oldrev/led-matrix/README.md

# 蓝牙 LED 矩阵控制器

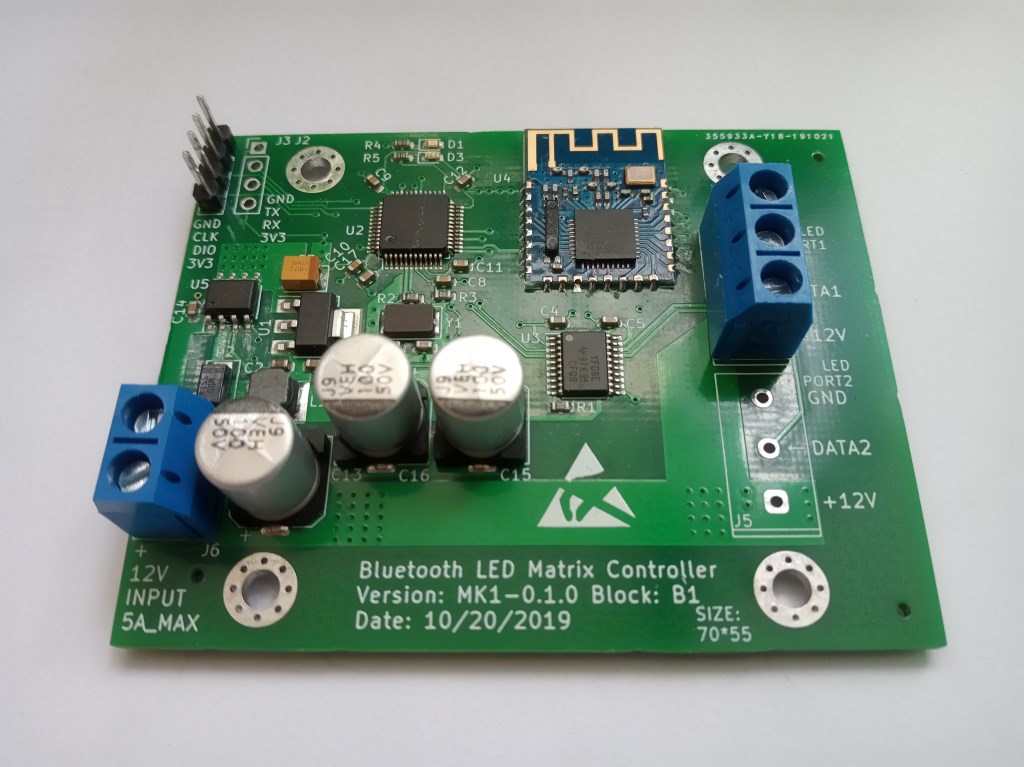
[picture p1: docs/images/board_photo.jpg]
PCB


详情文档推荐使用 mkdocs 构建并查看。

构建文档需要先安装 Python3 及相关依赖：

```bash
$pip install --user -r requirements.txt
```

安装完成以后，执行：

```bash
$mkdocs serve
```

然后用浏览器打开`http://localhost:8000`即可。
