oldrev/led-matrix/docs/index.md

PCB

# 关于此文档

**本项目文档使用 mkdocs 生成。**

For full documentation visit [mkdocs.org](https://mkdocs.org).

## 文档命令

* `mkdocs new [dir-name]` - Create a new project.
* `mkdocs serve` - Start the live-reloading docs server.
* `mkdocs build` - Build the documentation site.
* `mkdocs help` - Print this help message.

## 项目布局

    mkdocs.yml    # mkdocs 配置
    docs          # 文档目录
    firmware      # 单片机程序源代码
    demo          # 演示小程序源码
    circuit       # 电路设计文件（使用 KiCAD 5.1）
    casing        # 外壳建模文件（使用 FreeCAD）
    assets        # 参考文档等
