oldrev/led-matrix/docs/hw/casing.md

# 关于外壳

外壳使用公版防水室外接线盒。

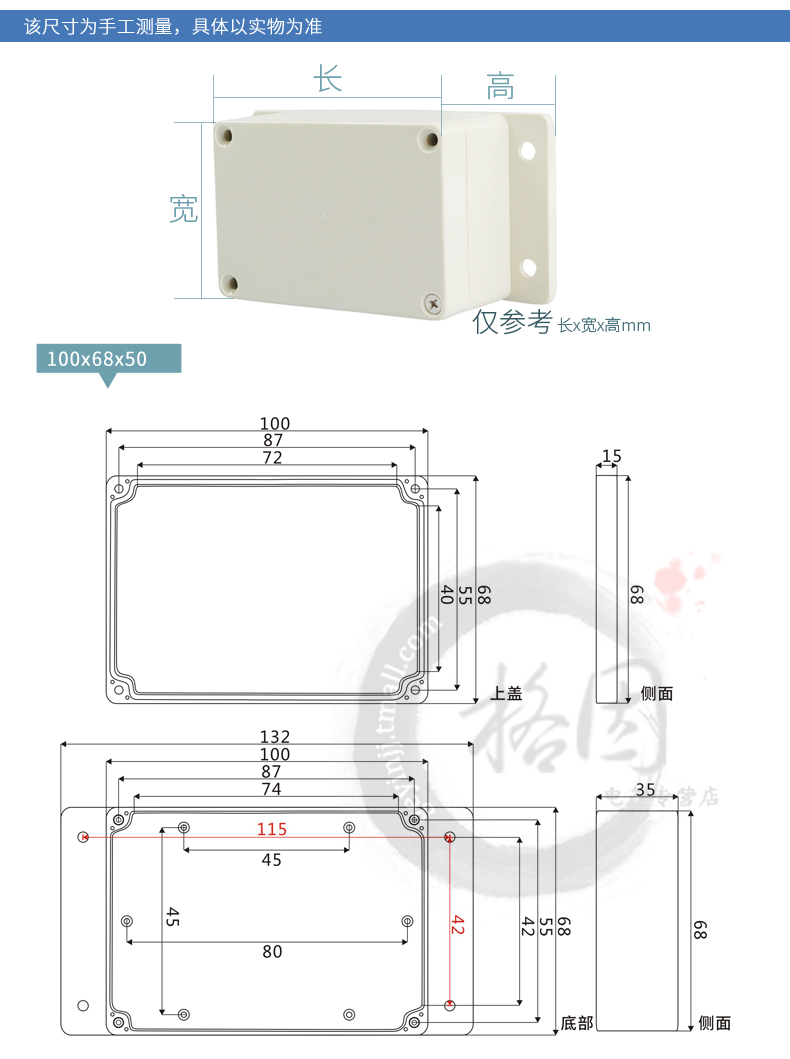
[picture p2: docs/hw/images/case_size.jpg]
PCB接口
