oldrev/led-matrix/casing/board.FCStd

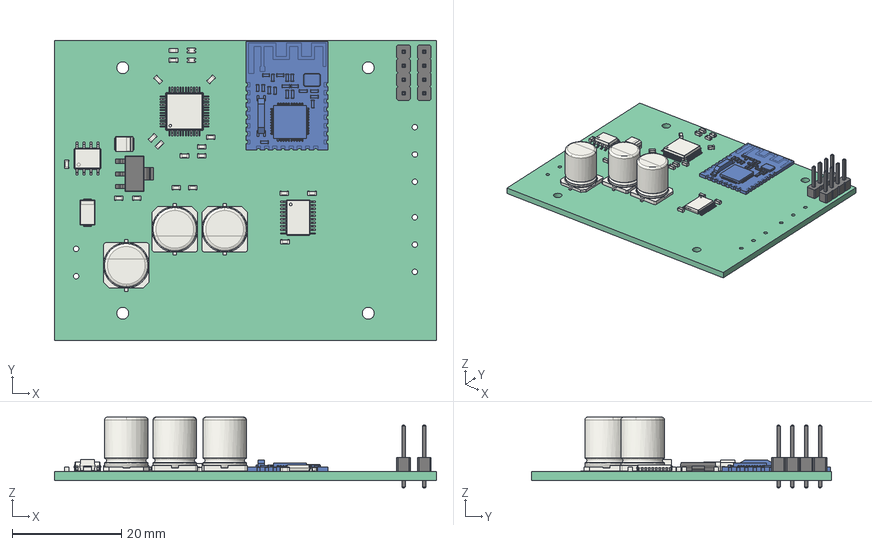
[picture p5: CAD file, 2019-11-02]
casing/board.FCStd
70.0 x 55.0 x 13.0 mm
Pcb
U3_TSSOP_20_44x65mm_P065mm_5DA9C0DB
U4_JDY-08_5DAB388E
C17_C_0603_1608Metric_5DAB3591
D3_D_0603_5DAB6C1B
C2_C_0603_1608Metric_5DAC7A63
J3_PinHeader_1x04_P254mm_Vertical_5DAB4AF9
J2_PinHeader_1x04_P254mm_Vertical_5DAB4AE1
C3_CP_EIA_3528_21_Kemet_B_5DAC7A95
C16_CP_Elec_8x10_5DAB24C7
C15_CP_Elec_8x10_5DAB249F
C13_CP_Elec_8x10_5DAB161F
D1_D_0603_5DAAA58A
U5_SOIC_8_39x49mm_P127mm_5DAA9B0B
D2_D_SMA_5DAA992D
C14_C_0603_1608Metric_5DAA9915
R5_C_0603_1608Metric_5DAA12DD
R4_C_0603_1608Metric_5DAA12CC
R3_C_0603_1608Metric_5DAA12BB
R2_C_0603_1608Metric_5DAA12AA
R1_C_0603_1608Metric_5DAA1299
C12_C_0603_1608Metric_5DAA1288
C11_C_0603_1608Metric_5DAA1277
C10_C_0603_1608Metric_5DAA1266
C9_C_0603_1608Metric_5DAA1255
C8_C_0603_1608Metric_5DAA1244
C7_C_0603_1608Metric_5DAA1233
C6_C_0603_1608Metric_5DAA1222
C5_C_0603_1608Metric_5DAA1211
C4_C_0603_1608Metric_5DAA1200
C1_C_0603_1608Metric_5DAC7AC9
U2_LQFP_48_7x7mm_P05mm_5DA9C0B7
U1_SOT_223_5DAC7AFE
