oldrev/led-matrix/circuit/3D-Package/JDY-08.stp

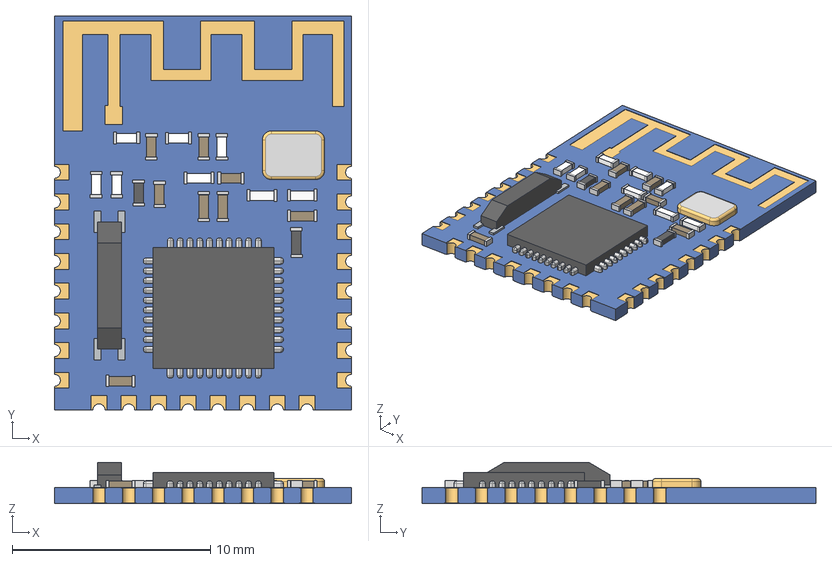
[picture p6: CAD file, 2019-11-02]
circuit/3D-Package/JDY-08.stp
15.0 x 19.9 x 2.08 mm
