oldrev/led-matrix/circuit/3D-Package/Crystal-5032-2P.stp

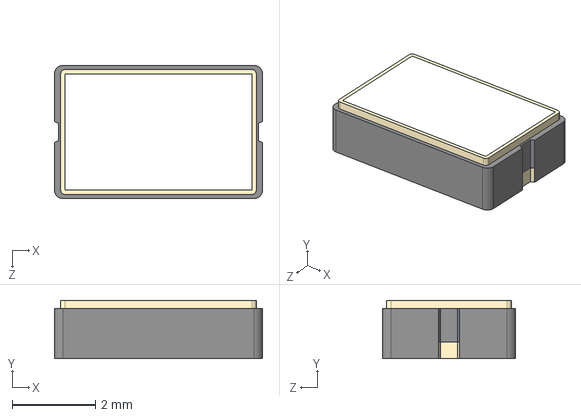
[picture p8: CAD file, 2019-11-02]
circuit/3D-Package/Crystal-5032-2P.stp
5.00 x 1.40 x 3.20 mm
