oldrev/led-matrix/circuit/LEDMatrix.kicad_pcb

## KiCad design circuit/LEDMatrix.kicad_pcb (2020-04-25)

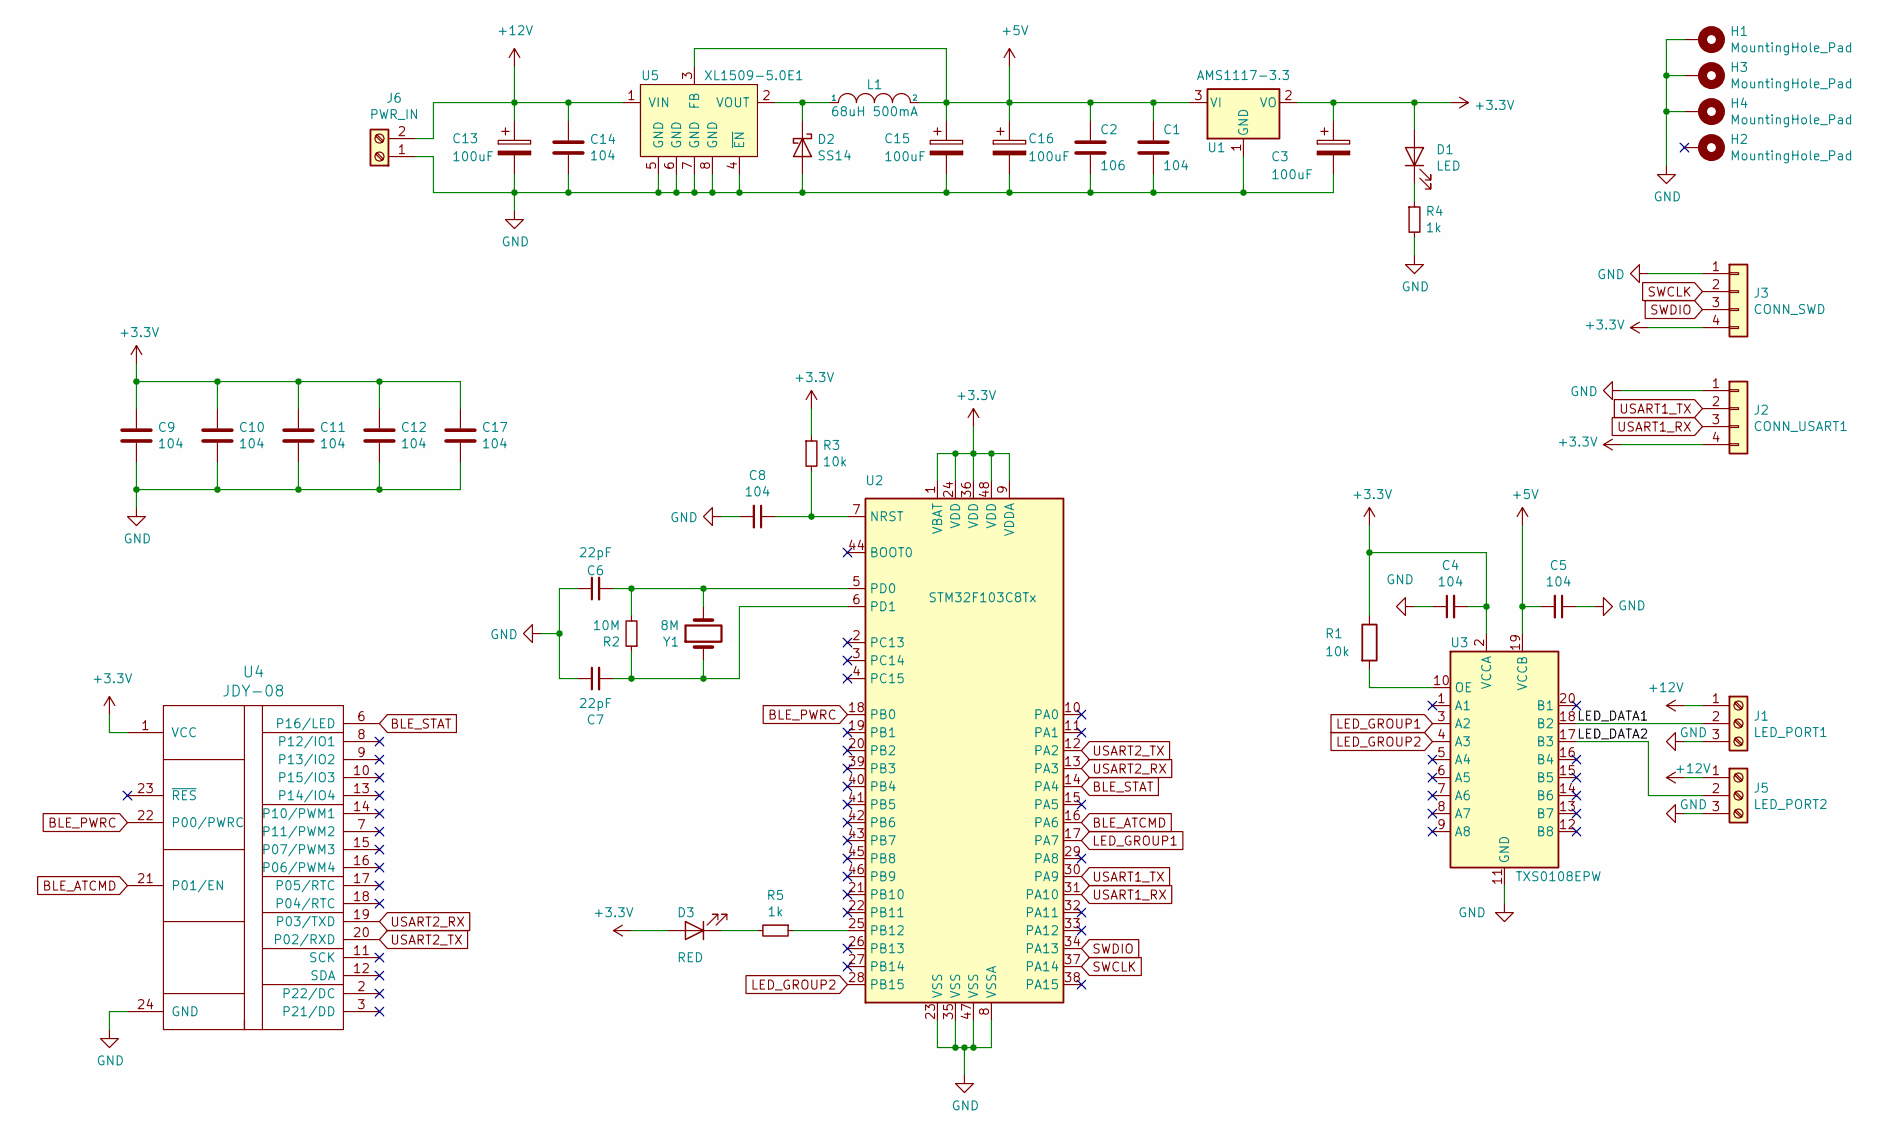
[picture p9: schematic LEDMatrix.sch, LED Matrix BLE Controller]

Parts:
C1, C4, C5, C8, C9, C10, C11, C12, C14, C17: 104; C_0603_1608Metric
C2: 106; C_0603_1608Metric; JLC_MODEL C19702
C3: 100uF; CP_EIA-3528-21_Kemet-B; JLC_MODEL TAJB107K006RNJ
C6, C7: 22pF; C_0603_1608Metric
C13, C15, C16: 100uF; CP_Elec_8x10; JLC_MODEL C134507
D1: LED; D_0603_1608Metric
D2: SS14; D_SMA
D3: RED; D_0603_1608Metric
H1, H2, H3, H4: MountingHole_Pad; MountingHole_3.2mm_M3_Pad_Via
J1: LED_PORT1; TerminalBlock_JL301-5.00-3P
J2: CONN_USART1; PinHeader_1x04_P2.54mm_Vertical
J3: CONN_SWD; PinHeader_1x04_P2.54mm_Vertical
J5: LED_PORT2; TerminalBlock_JL301-5.00-3P
J6: PWR_IN; TerminalBlock_JL301-5.00-2P
L1: 68uH 500mA; L_Taiyo-Yuden_NR-40xx_HandSoldering
R1, R3: 10k; C_0603_1608Metric
R2: 10M; C_0603_1608Metric
R4, R5: 1k; C_0603_1608Metric
U1: AMS1117-3.3; SOT-223-3_TabPin2; JLC_MODEL C6186
U2: STM32F103C8Tx; LQFP-48_7x7mm_P0.5mm
U3: TXS0108EPW; TSSOP-20_4.4x6.5mm_P0.65mm
U4: JDY-08; JDY-08_HandSoldering
U5: XL1509-5.0E1; SOIC-8_3.9x4.9mm_P1.27mm; JLC_MODEL C61063
Y1: 8M; Crystal_SMD_5032-2Pin_5.0x3.2mm; JLC_MODEL C115962

Connections:
+3V3: C3.1, C4.2, C9.1, C10.1, C11.1, C12.1, C17.1, D1.2 (A), D3.2 (A), J2.4, J3.4, R1.1, R3.1, U1.2 (VO), U2.1 (VBAT), U2.9 (VDDA), U2.24 (VDD), U2.36 (VDD), U2.48 (VDD), U3.2 (VCCA), U4.1 (VCC)
+5V: C1.1, C2.1, C5.2, C15.1, C16.1, L1.2, U1.3 (VI), U3.19 (VCCB), U5.3 (FB)
+12V: C13.1, C14.1, J1.1, J5.1, J6.2, U5.1 (VIN)
/LED_DATA1: J1.2, U3.18 (B2)
/LED_DATA2: J5.2, U3.17 (B3)
BLE_ATCMD: U2.16 (PA6), U4.21 (P01/EN)
BLE_PWRC: U2.18 (PB0), U4.22 (P00/PWRC)
BLE_STAT: U2.14 (PA4), U4.6 (P16/LED)
GND: C1.2, C2.2, C3.2, C4.1, C5.1, C6.1, C7.1, C8.2, C9.2, C10.2, C11.2, C12.2, C13.2, C14.2, C15.2, C16.2, C17.2, D2.2 (A), H1.1, H3.1, H4.1, J1.3, J2.1, J3.1, J5.3, J6.1, R4.2, U1.1 (GND), U2.8 (VSSA), U2.23 (VSS), U2.35 (VSS), U2.47 (VSS), U3.11 (GND), U4.24 (GND), U5.4 (~EN), U5.5 (GND), U5.6 (GND), U5.7 (GND), U5.8 (GND)
LED_GROUP1: U2.17 (PA7), U3.3 (A2)
LED_GROUP2: U2.28 (PB15), U3.4 (A3)
unnamed: C6.2, R2.2, U2.5 (PD0), Y1.2
unnamed: C7.2, R2.1, U2.6 (PD1), Y1.1
unnamed: C8.1, R3.2, U2.7 (NRST)
unnamed: D1.1 (K), R4.1
unnamed: D2.1 (K), L1.1, U5.2 (VOUT)
unnamed: D3.1 (K), R5.2
unnamed: R1.2, U3.10 (OE)
unnamed: R5.1, U2.25 (PB12)
SWCLK: J3.2, U2.37 (PA14)
SWDIO: J3.3, U2.34 (PA13)
USART1_RX: J2.3, U2.31 (PA10)
USART1_TX: J2.2, U2.30 (PA9)
USART2_RX: U2.13 (PA3), U4.19 (P03/TXD)
USART2_TX: U2.12 (PA2), U4.20 (P02/RXD)

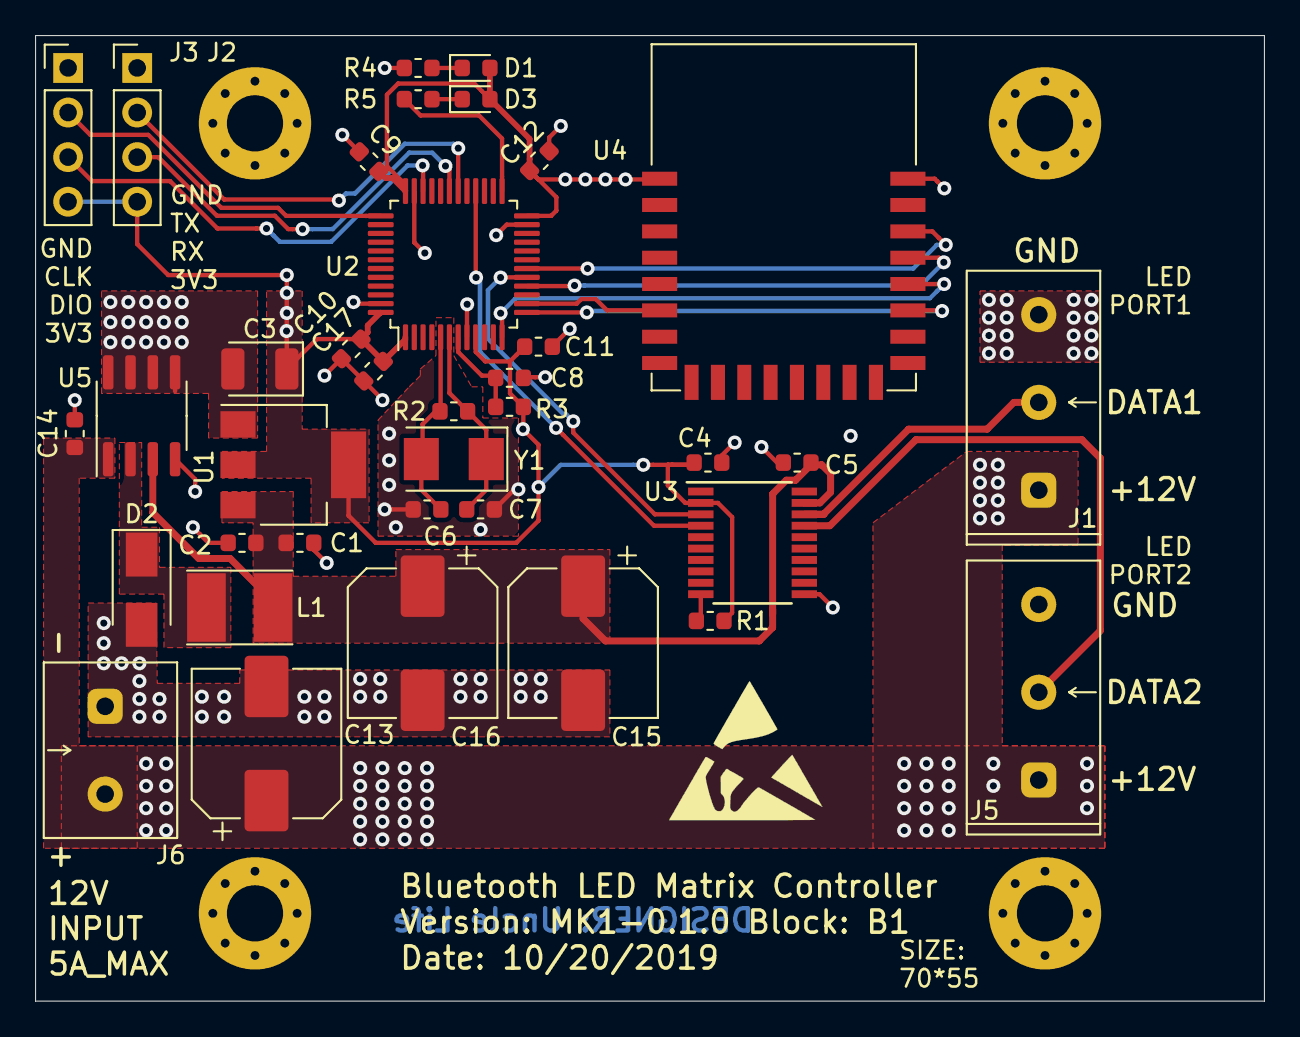
[picture p10: board LEDMatrix.kicad_pcb from above]

Board: 2 copper layers, 70.0 x 55.0 mm, 41 parts (0 on the bottom side), 25 nets.
