oldrev/led-matrix/firmware/Src/main.c

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

/* Includes ------------------------------------------------------------------*/
#include "main.h"
#include "cmsis_os.h"

/* USER CODE BEGIN Includes */
#include <string.h>
#include <stdlib.h>

#include "devices/devices.h"
#include "settings.h"
#include "comm.h"
/* USER CODE END Includes */

SPI_HandleTypeDef hspi1;
SPI_HandleTypeDef hspi2;
DMA_HandleTypeDef hdma_spi1_tx;
DMA_HandleTypeDef hdma_spi2_tx;

UART_HandleTypeDef huart1;
UART_HandleTypeDef huart2;
DMA_HandleTypeDef hdma_usart2_tx;
DMA_HandleTypeDef hdma_usart2_rx;

osThreadId defaultTaskHandle;
osThreadId displayTaskHandle;
osMessageQId g_cmdBusHandle;
/* USER CODE BEGIN PV */

Display g_display[1];

/* USER CODE END PV */

void SystemClock_Config(void);
static void MX_GPIO_Init(void);
static void MX_DMA_Init(void);
static void MX_SPI1_Init(void);
static void MX_SPI2_Init(void);
static void MX_USART1_UART_Init(void);
static void MX_USART2_UART_Init(void);
void TaskProc_Default(void const * argument);
void TaskProc_Display(void const * argument);

/* USER CODE BEGIN PFP */
static int MsgProc_System_Reset(const Comm_RemoteHeader* header, const void* args);
static int MsgProc_System_Hello(const Comm_RemoteHeader* header, const void* args);
static int MsgProc_Display_Fill(const Comm_RemoteHeader* header, const void* args);
static int MsgProc_Display_SetPixel(const Comm_RemoteHeader* header, const void* args);
static int MsgProc_Display_SetPixelXY(const Comm_RemoteHeader* header, const void* args);
static int MsgProc_Config_DisplaySettings(const Comm_RemoteHeader* header, const void* args);
static int MsgProc_Config_Restore(const Comm_RemoteHeader* header, const void* args);
/* USER CODE END PFP */

/* USER CODE BEGIN 0 */
static int MsgProc_System_Reset(const Comm_RemoteHeader* header, const void* args)
{
    HAL_NVIC_SystemReset();
    return 0;
}

static int MsgProc_System_Hello(const Comm_RemoteHeader* header, const void* args)
{
    uint8_t responseBody[6];
    memcpy(responseBody, JDY08_GetMac(), 6);

    if (Comm_ReplyPackage(header->ID, header->Type, responseBody, 6) != 0) {
        return -1;
    }
    return 0;
}

static int MsgProc_Display_Fill(const Comm_RemoteHeader* header, const void* args)
{
    const uint8_t* pColorIndex = (const uint8_t*)args;
    if (Display_Fill(&g_display[0], *pColorIndex) != 0) {
        return -1;
    }
    return 0;
}

static int MsgProc_Display_SetPixel(const Comm_RemoteHeader* header, const void* args)
{
    const uint8_t* buf = (const uint8_t*)args;
    const uint16_t* pixelIndex = (const uint16_t*)buf;
    const uint8_t* colorIndex = buf + 2;
    if (Display_SetPixel(&g_display[0], *pixelIndex, *colorIndex) != 0) {
        return -1;
    }
    return 0;
}

static int MsgProc_Display_SetPixelXY(const Comm_RemoteHeader* header, const void* args)
{
    /*
    const uint8_t* buf = (const uint8_t*)args;
    const uint16_t* x = (const uint16_t*)buf;
    const uint16_t* y = (const uint16_t*)(buf + 2);
    const uint8_t* colorIndex = buf + 4;
    */
    const Comm_Display_SetPixelXY_Arguments* typedArgs = 
        (const Comm_Display_SetPixelXY_Arguments*) args;
    if (Display_SetPixelXY(&g_display[0], typedArgs->X, typedArgs->Y, typedArgs->ColorIndex) != 0) {
        return -1;
    }
    return 0;
}

static int MsgProc_Config_DisplaySettings(const Comm_RemoteHeader* header, const void* args)
{
    const uint8_t* buf = (const uint8_t*)args;
    AppSettings settings;

    memcpy(&settings, (const void*)Settings_Get(), sizeof(AppSettings));
    // 执行显示设置修改
    settings.DisplaySettings.LedCount = *((const uint16_t*)buf);
    settings.DisplaySettings.XMax = (*(const uint16_t*)(buf + 2));
    settings.DisplaySettings.YMax = (*(const uint16_t*)(buf + 4));
    settings.DisplaySettings.XSkip = (*(const uint16_t*)(buf + 6));
    settings.DisplaySettings.YSkip = (*(const uint16_t*)(buf + 8));

    uint16_t bytesIndex = 0;
    const uint8_t* paletteBytes = buf + 10;
    for (uint16_t i = 0; i < PALETTE_SIZE; i++) {
        settings.DisplaySettings.Palette[i].Red = paletteBytes[bytesIndex];
        settings.DisplaySettings.Palette[i].Green = paletteBytes[bytesIndex + 1];
        settings.DisplaySettings.Palette[i].Blue = paletteBytes[bytesIndex + 2];
        bytesIndex += 3;
    }
    // 保存设置
    Settings_Save(&settings);
    // 返回响应
    uint8_t responseArgs = 0;
    if (Comm_ReplyPackage(header->ID, header->Type, &responseArgs, 1) != 0) {
        return -1;
    }
    // 执行重启
    HAL_NVIC_SystemReset();
    return 0;
}

static int MsgProc_Config_Restore(const Comm_RemoteHeader* header, const void* args)
{
    // 恢复默认设置
    Settings_Restore();
    // 执行重启
    HAL_NVIC_SystemReset();
    return 0;
}
/* USER CODE END 0 */

/**
  * @brief  The application entry point.
  * @retval int
  */
int main(void)
{
  

  /* MCU Configuration--------------------------------------------------------*/

  /* Reset of all peripherals, Initializes the Flash interface and the Systick. */
  HAL_Init();

  /* Configure the system clock */
  SystemClock_Config();

  /* Initialize all configured peripherals */
  MX_GPIO_Init();
  MX_DMA_Init();
  MX_SPI1_Init();
  MX_SPI2_Init();
  MX_USART1_UART_Init();
  MX_USART2_UART_Init();
  /* USER CODE BEGIN 2 */

    // 初始化指示灯
    Indicator_Init();
    Indicator_TurnOn(0);


    Settings_Init();
    if (Settings_IsFirstBoot()) {
        Settings_Restore();
    }


    if (Display_Init(&g_display[0], &Settings_Get()->DisplaySettings, &hspi1) != 0) {
        Error_Handler();
    }


    if (JDY08_Init(&huart2, &hdma_usart2_rx) != 0) {
        Error_Handler();
    }

  /* USER CODE END 2 */

  /* USER CODE BEGIN RTOS_MUTEX */
    /* add mutexes, ... */
  /* USER CODE END RTOS_MUTEX */

  /* USER CODE BEGIN RTOS_SEMAPHORES */
    /* add semaphores, ... */
  /* USER CODE END RTOS_SEMAPHORES */

  /* USER CODE BEGIN RTOS_TIMERS */
    /* start timers, add new ones, ... */
  /* USER CODE END RTOS_TIMERS */

  /* Create the queue(s) */
  /* definition and creation of g_cmdBus */
  osMessageQDef(g_cmdBus, 2, 512);
  g_cmdBusHandle = osMessageCreate(osMessageQ(g_cmdBus), NULL);

  /* USER CODE BEGIN RTOS_QUEUES */
    /* add queues, ... */
  /* USER CODE END RTOS_QUEUES */

  /* Create the thread(s) */
  /* definition and creation of defaultTask */
  osThreadDef(defaultTask, TaskProc_Default, osPriorityNormal, 0, 128);
  defaultTaskHandle = osThreadCreate(osThread(defaultTask), NULL);

  /* definition and creation of displayTask */
  osThreadDef(displayTask, TaskProc_Display, osPriorityIdle, 0, 128);
  displayTaskHandle = osThreadCreate(osThread(displayTask), NULL);

  /* USER CODE BEGIN RTOS_THREADS */
    /* add threads, ... */
  /* USER CODE END RTOS_THREADS */

  /* Start scheduler */
  osKernelStart();
  
  /* We should never get here as control is now taken by the scheduler */

  /* Infinite loop */
  /* USER CODE BEGIN WHILE */
    while (1) {
    /* USER CODE END WHILE */

    /* USER CODE BEGIN 3 */
    }
  /* USER CODE END 3 */
}

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
/* USER CODE BEGIN Header_TaskProc_Default */
/**
 * @brief  Function implementing the defaultTask thread.
 * @param  argument: Not used
 * @retval None
 */
/* USER CODE END Header_TaskProc_Default */
void TaskProc_Default(void const * argument)
{
    
    
    
    

  /* USER CODE BEGIN 5 */

    if (Comm_Init(g_cmdBusHandle) != 0) {
        Error_Handler();
    }

    osEvent event;
    /* Infinite loop */
    for (;;) {
        osThreadYield();
        event = osMessageGet(g_cmdBusHandle, osWaitForever); // wait for message
        if (event.status == osEventMessage) {

            Comm_RemoteHeader header = { 0 };
            Comm_ParsePackageHeader(event.value.p, &header);
            const uint8_t* arguments = ((const uint8_t*)event.value.p) + COMM_REMOTE_PACKAGE_HEADER_SIZE;
            switch (header.Type) {
            case MESSAGE_SYSTEM_HELLO:
                MsgProc_System_Hello(&header, arguments);
                break;
            case MESSAGE_SYSTEM_RESET:
                MsgProc_System_Reset(&header, arguments);
                break;
            case MESSAGE_DISPLAY_FILL:
                MsgProc_Display_Fill(&header, arguments);
                break;
            case MESSAGE_DISPLAY_SET_PIXEL:
                MsgProc_Display_SetPixel(&header, arguments);
                break;
            case MESSAGE_DISPLAY_SET_PIXELXY:
                MsgProc_Display_SetPixelXY(&header, arguments);
                break;
            case MESSAGE_CONFIG_DISPLAY:
                MsgProc_Config_DisplaySettings(&header, arguments);
                break;
            case MESSAGE_CONFIG_RESTORE:
                MsgProc_Config_Restore(&header, arguments);
                break;
            default:
                break;
            }
        }
    }
  /* USER CODE END 5 */ 
}

/* USER CODE BEGIN Header_TaskProc_Display */
/**
 * @brief Function implementing the displayTask thread.
 * @param argument: Not used
 * @retval None
 */
/* USER CODE END Header_TaskProc_Display */
void TaskProc_Display(void const * argument)
{
  /* USER CODE BEGIN TaskProc_Display */
    uint32_t indicatorTimer = 0;
    uint32_t displayTimer = 0;
    /* Infinite loop */
    for (;;) {
        osThreadYield();
        // 刷新显示
        if (HAL_GetTick() - displayTimer >= 40) {
            Display_Update(&g_display[0]);
            displayTimer = HAL_GetTick();
        }


        uint32_t indicatorInterval = JDY08_IsConnected() ? 400 : 1000;
        if (HAL_GetTick() - indicatorTimer >= indicatorInterval) {
            Indicator_TurnOnInPeriod(0, 200);
            indicatorTimer = HAL_GetTick();
        }

        Indicator_Drive();
    }
  /* USER CODE END TaskProc_Display */
}

/**
  * @brief  Period elapsed callback in non blocking mode
  * @note   This function is called  when TIM4 interrupt took place, inside
  * HAL_TIM_IRQHandler(). It makes a direct call to HAL_IncTick() to increment
  * a global variable "uwTick" used as application time base.
  * @param  htim : TIM handle
  * @retval None
  */
void HAL_TIM_PeriodElapsedCallback(TIM_HandleTypeDef *htim)
{
  if (htim->Instance == TIM4) {
    HAL_IncTick();
  }
}

/**
  * @brief  This function is executed in case of error occurrence.
  * @retval None
  */
void Error_Handler(void)
{
  /* USER CODE BEGIN Error_Handler_Debug */
    /* User can add his own implementation to report the HAL error return state */
    //打开指示灯常亮，然后卡在这里
    Indicator_TurnOn(0);
    while (1) {
    }
  /* USER CODE END Error_Handler_Debug */
}

#ifdef  USE_FULL_ASSERT
/**
  * @brief  Reports the name of the source file and the source line number
  *         where the assert_param error has occurred.
  * @param  file: pointer to the source file name
  * @param  line: assert_param error line source number
  * @retval None
  */
void assert_failed(uint8_t *file, uint32_t line)
{ 
  /* USER CODE BEGIN 6 */
    /* User can add his own implementation to report the file name and line
       number,
       tex: printf("Wrong parameters value: file %s on line %d\r\n", file, line)
     */
  /* USER CODE END 6 */
}
#endif /* USE_FULL_ASSERT */

/************************ (C) COPYRIGHT STMicroelectronics *****END OF FILE****/
