oldrev/led-matrix/firmware/LEDMatrix.ioc

Mcu.UserName=STM32F103C8Tx
PA10.Signal=USART1_RX
PA13.Signal=SYS_JTMS-SWDIO
PA14.Signal=SYS_JTCK-SWCLK
PA2.Signal=USART2_TX
PA3.Signal=USART2_RX
PA4.GPIO_Label=BLE_STAT
PA4.Signal=GPIO_Input
PA5.Signal=SPI1_SCK
PA6.GPIO_Label=BLE_ATCMD
PA6.Signal=GPIO_Output
PA7.Signal=SPI1_MOSI
PA9.Signal=USART1_TX
PB0.GPIO_Label=BLE_PWRC
PB0.Signal=GPIO_Output
PB12.GPIO_Label=DBG_LED
PB12.Signal=GPIO_Output
PB13.Signal=SPI2_SCK
PB15.Signal=SPI2_MOSI
PD0-OSC_IN.Signal=RCC_OSC_IN
PD1-OSC_OUT.Signal=RCC_OSC_OUT
