oldrev/led-matrix/firmware/Inc/main.h

#define FW_VERSION     0x0100 //版本
#define BLE_STAT_Pin GPIO_PIN_4
#define BLE_STAT_GPIO_Port GPIOA
#define BLE_ATCMD_Pin GPIO_PIN_6
#define BLE_ATCMD_GPIO_Port GPIOA
#define BLE_PWRC_Pin GPIO_PIN_0
#define BLE_PWRC_GPIO_Port GPIOB
#define DBG_LED_Pin GPIO_PIN_12
#define DBG_LED_GPIO_Port GPIOB
