oldrev/led-matrix/(commit log)

2019-11-02 初次提交
    [Crystal-5032-2P.stp, F4-2.FCStd, JDY-08.stp, LEDMatrix.kicad_pcb, LEDMatrix.sch, LEDMatrix_BOM.csv, board.FCStd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]
2019-11-02 完善文档
    [LEDMatrix.kicad_pcb]
2019-11-02 完善分包处理
2019-11-04 文档更新
2019-11-04 重新调整文档个是
2019-11-04 完善 README
2019-11-04 解决文档错误
2019-11-04 文档调整，增加色盘颜色
2019-11-04 增加外壳图纸
2019-11-05 完善小程序
2019-11-07 增加显示配置的协议说明
2019-11-07 增加复位功能
2019-11-07 解决发送快了会闪烁的 bug
2019-11-07 解决 release 无法编译的问题
2019-11-07 增加恢复出厂设置功能
2019-11-08 代码优化
2020-08-25 更新方法
2020-08-25 增加检查是否开启广播的功能
2020-08-26 更新名称
2020-08-26 更新框架文档等
2020-08-26 更新文档
2020-08-26 调整灯珠参数
2020-08-27 修复显示 bug
